devoltamp/mp3-player/README.md

bluetooth audio receiver (A2DP Sink) built for the ESP32 board using an I2S DAC (e.g., PCM5102, MAX98357A) and a 1.3' OLED display module. -- *kinda like a potato ipod!*  

---
> [!NOTE]
> if you wanna look at clear image open the .sch file in kicad -- that would be much clear, because this is not SVG file.

## claude's plan played on it

https://github.com/user-attachments/assets/69324d31-6606-432c-874e-f7c642e5d512

## using, MAX98357A - output as speaker
  

---
[huyvector](https://www.huyvector.org/smart-devices/esp32-music-player) -- noice clarification
