devoltamp/mp3-player/hardware/README.md

> [!NOTE]
> if you wanna look at clear image open the .sch file in kicad -- that would be much clear, because this is not SVG file.

## using, MAX98357A - output as speaker


## using PCM5102A - output as earphone (much costlier)
