devoltamp/mp3-player/hardware/mp3.kicad_sch

## KiCad design hardware/mp3.kicad_sch (2026-10-23)

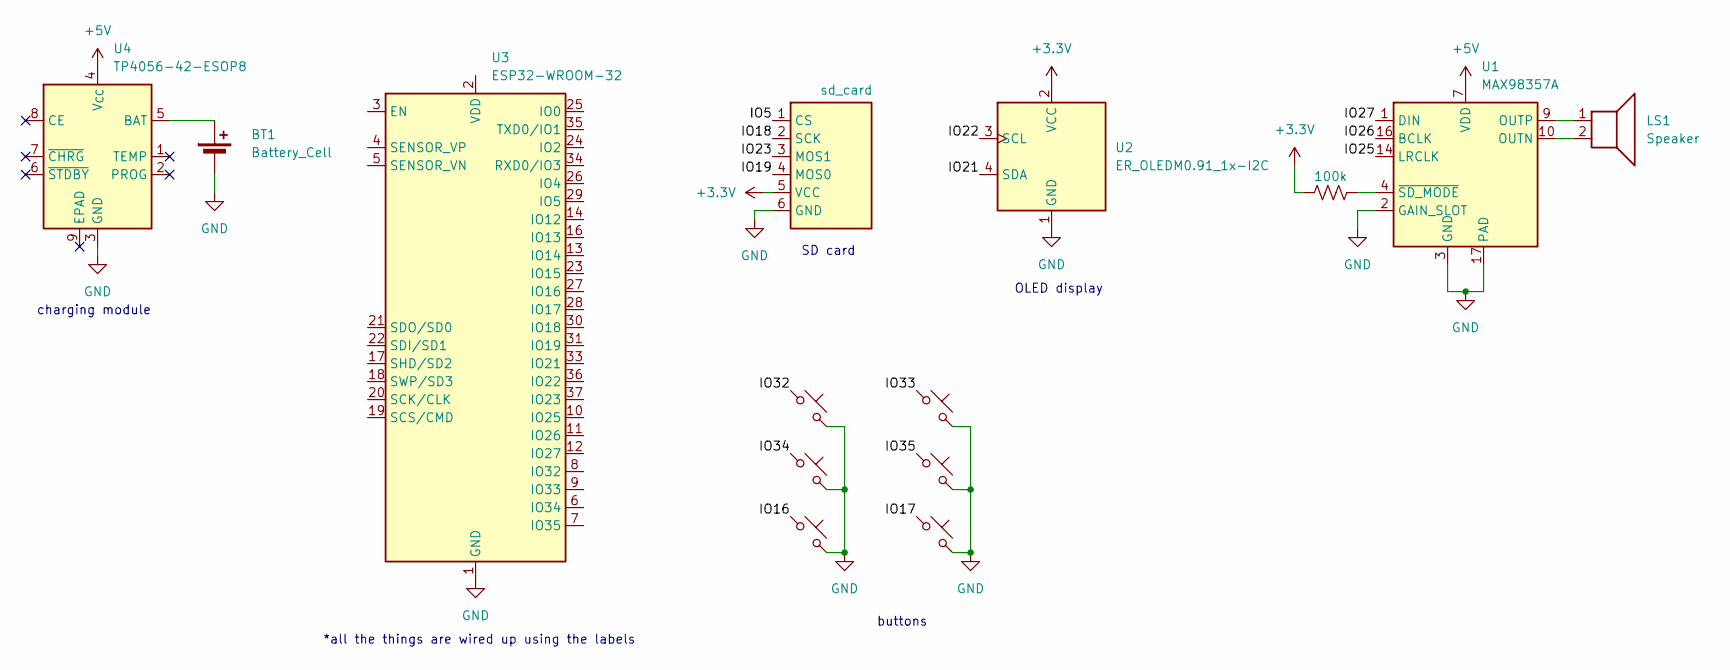
[picture p12: schematic mp3.kicad_sch]

Parts:
BT1: Battery_Cell
LS1: Speaker
R1: 100k
SW1, SW2, SW3, SW4, SW5, SW6: SW_Push_45deg
U1: MAX98357A; TQFN-16-1EP_3x3mm_P0.5mm_EP1.23x1.23mm
U2: ER_OLEDM0.91_1x-I2C
U3: ESP32-WROOM-32
U4: TP4056-42-ESOP8; SOIC-8-1EP_3.9x4.9mm_P1.27mm_EP2.41x3.3mm_ThermalVias
sd_card: (no value)

Connections:
+3.3V: R1.1, U2.2 (VCC), sd_card.5 (VCC)
+5V: U1.7 (VDD), U1.8 (VDD), U4.4 (V_{CC})
GND: BT1.2 (-), SW1.2, SW2.2, SW3.2, SW4.2, SW5.2, SW6.2, U1.2 (GAIN_SLOT), U1.3 (GND), U1.11 (GND), U1.15 (GND), U1.17 (PAD), U2.1 (GND), U3.1 (GND), U3.15 (GND), U3.38 (GND), U3.39 (GND), U4.3 (GND), sd_card.6 (GND)
IO5: sd_card.1 (CS)
IO16: SW5.1
IO17: SW6.1
IO18: sd_card.2 (SCK)
IO19: sd_card.4 (MOS0)
IO21: U2.4 (SDA)
IO22: U2.3 (SCL)
IO23: sd_card.3 (MOS1)
IO25: U1.14 (LRCLK)
IO26: U1.16 (BCLK)
IO27: U1.1 (DIN)
IO32: SW1.1
IO33: SW2.1
IO34: SW3.1
IO35: SW4.1
unnamed: BT1.1 (+), U4.5 (BAT)
unnamed: LS1.1, U1.9 (OUTP)
unnamed: LS1.2, U1.10 (OUTN)
unnamed: R1.2, U1.4 (~SD_MODE)

Notes on the sheet:
charging module
buttons
*all the things are wired up using the labels
OLED display
SD card
