devoltamp/mp3-player/hardware/with headphone.kicad_sch

## KiCad design hardware/with headphone.kicad_sch (2026-10-23)

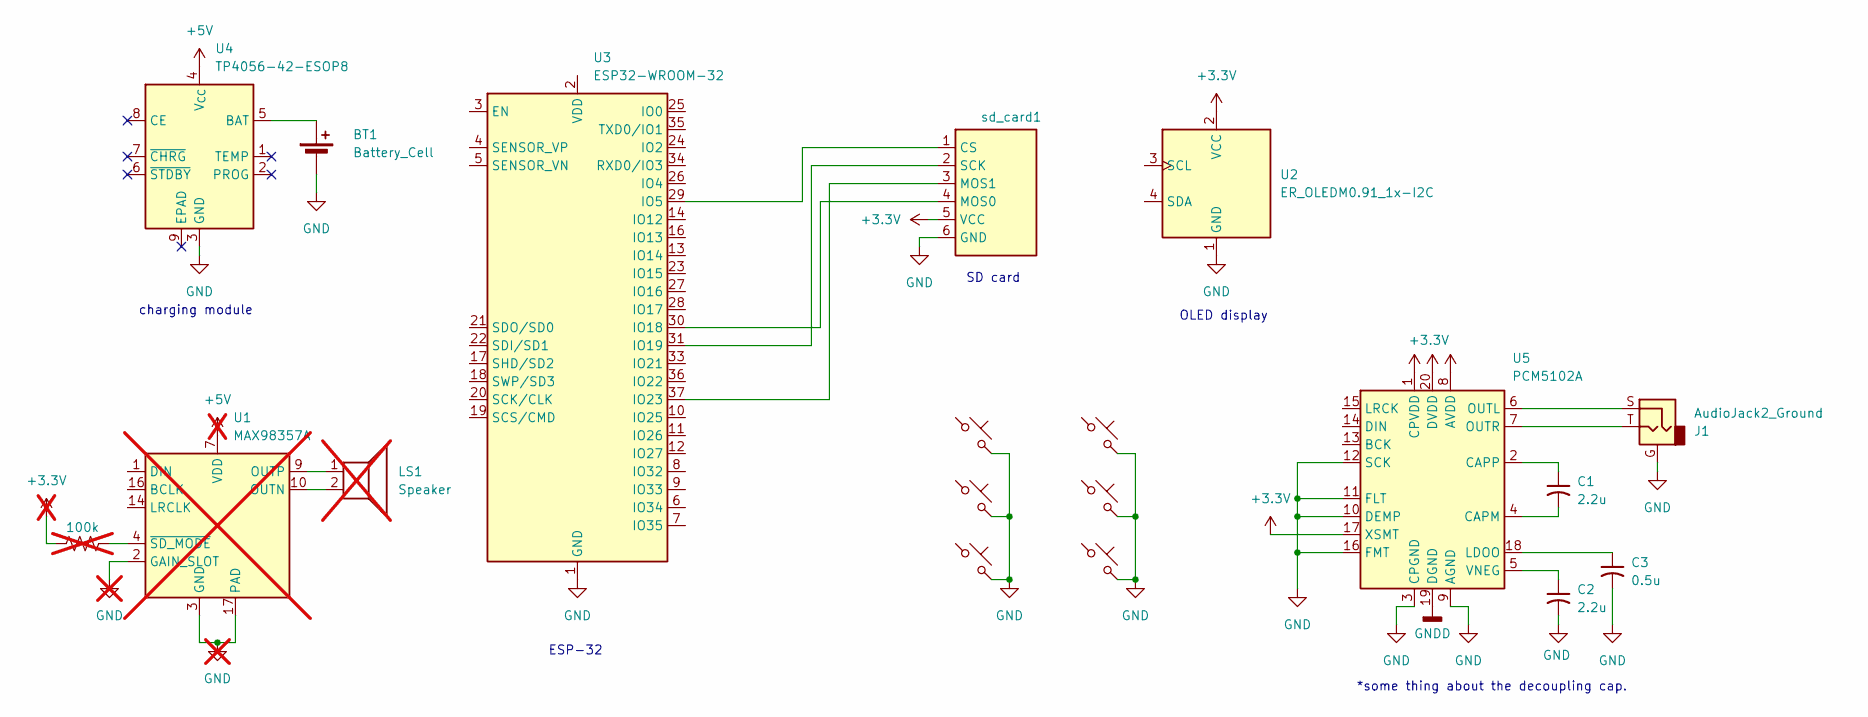
[picture p13: schematic with headphone.kicad_sch]

Parts:
BT1: Battery_Cell
C1, C2: 2.2u
C3: 0.5u
J1: AudioJack2_Ground
LS1: Speaker; not fitted
R1: 100k; not fitted
SW1, SW2, SW3, SW4, SW5, SW6: SW_Push_45deg
U1: MAX98357A; TQFN-16-1EP_3x3mm_P0.5mm_EP1.23x1.23mm; not fitted
U2: ER_OLEDM0.91_1x-I2C
U3: ESP32-WROOM-32
U4: TP4056-42-ESOP8; SOIC-8-1EP_3.9x4.9mm_P1.27mm_EP2.41x3.3mm_ThermalVias
U5: PCM5102A; TSSOP-20_4.4x6.5mm_P0.65mm
sd_card1: (no value)

Connections:
+3.3V: R1.1, U2.2 (VCC), U5.1 (CPVDD), U5.8 (AVDD), U5.17 (XSMT), U5.20 (DVDD), sd_card1.5 (VCC)
+5V: U1.7 (VDD), U1.8 (VDD), U4.4 (V_{CC})
GND: BT1.2 (-), C2.2, C3.2, J1.G, SW1.2, SW2.2, SW3.2, SW4.2, SW5.2, SW6.2, U1.2 (GAIN_SLOT), U1.3 (GND), U1.11 (GND), U1.15 (GND), U1.17 (PAD), U2.1 (GND), U3.1 (GND), U3.15 (GND), U3.38 (GND), U3.39 (GND), U4.3 (GND), U5.3 (CPGND), U5.9 (AGND), U5.10 (DEMP), U5.11 (FLT), U5.12 (SCK), U5.16 (FMT), sd_card1.6 (GND)
GNDD: U5.19 (DGND)
unnamed: BT1.1 (+), U4.5 (BAT)
unnamed: C1.1, U5.2 (CAPP)
unnamed: C1.2, U5.4 (CAPM)
unnamed: C2.1, U5.5 (VNEG)
unnamed: C3.1, U5.18 (LDOO)
unnamed: J1.S, U5.6 (OUTL)
unnamed: J1.T, U5.7 (OUTR)
unnamed: LS1.1, U1.9 (OUTP)
unnamed: LS1.2, U1.10 (OUTN)
unnamed: R1.2, U1.4 (~SD_MODE)
unnamed: U3.29 (IO5), sd_card1.1 (CS)
unnamed: U3.30 (IO18), sd_card1.4 (MOS0)
unnamed: U3.31 (IO19), sd_card1.2 (SCK)
unnamed: U3.37 (IO23), sd_card1.3 (MOS1)

Notes on the sheet:
*some thing about the decoupling cap.
charging module
OLED display
SD card
ESP-32
