devoltamp/mp3-player/(commit log)

2026-10-23 main schematic file -- if you wanna edit
    [mp3.kicad_sch]
2026-10-23 using the PCM102A
    [with headphone.kicad_sch]
